DanielAttih/Computer-Temperature-Sensor/hardware/PCtemp.kicad_sch

## KiCad design hardware/PCtemp.kicad_sch (2026-10-24)

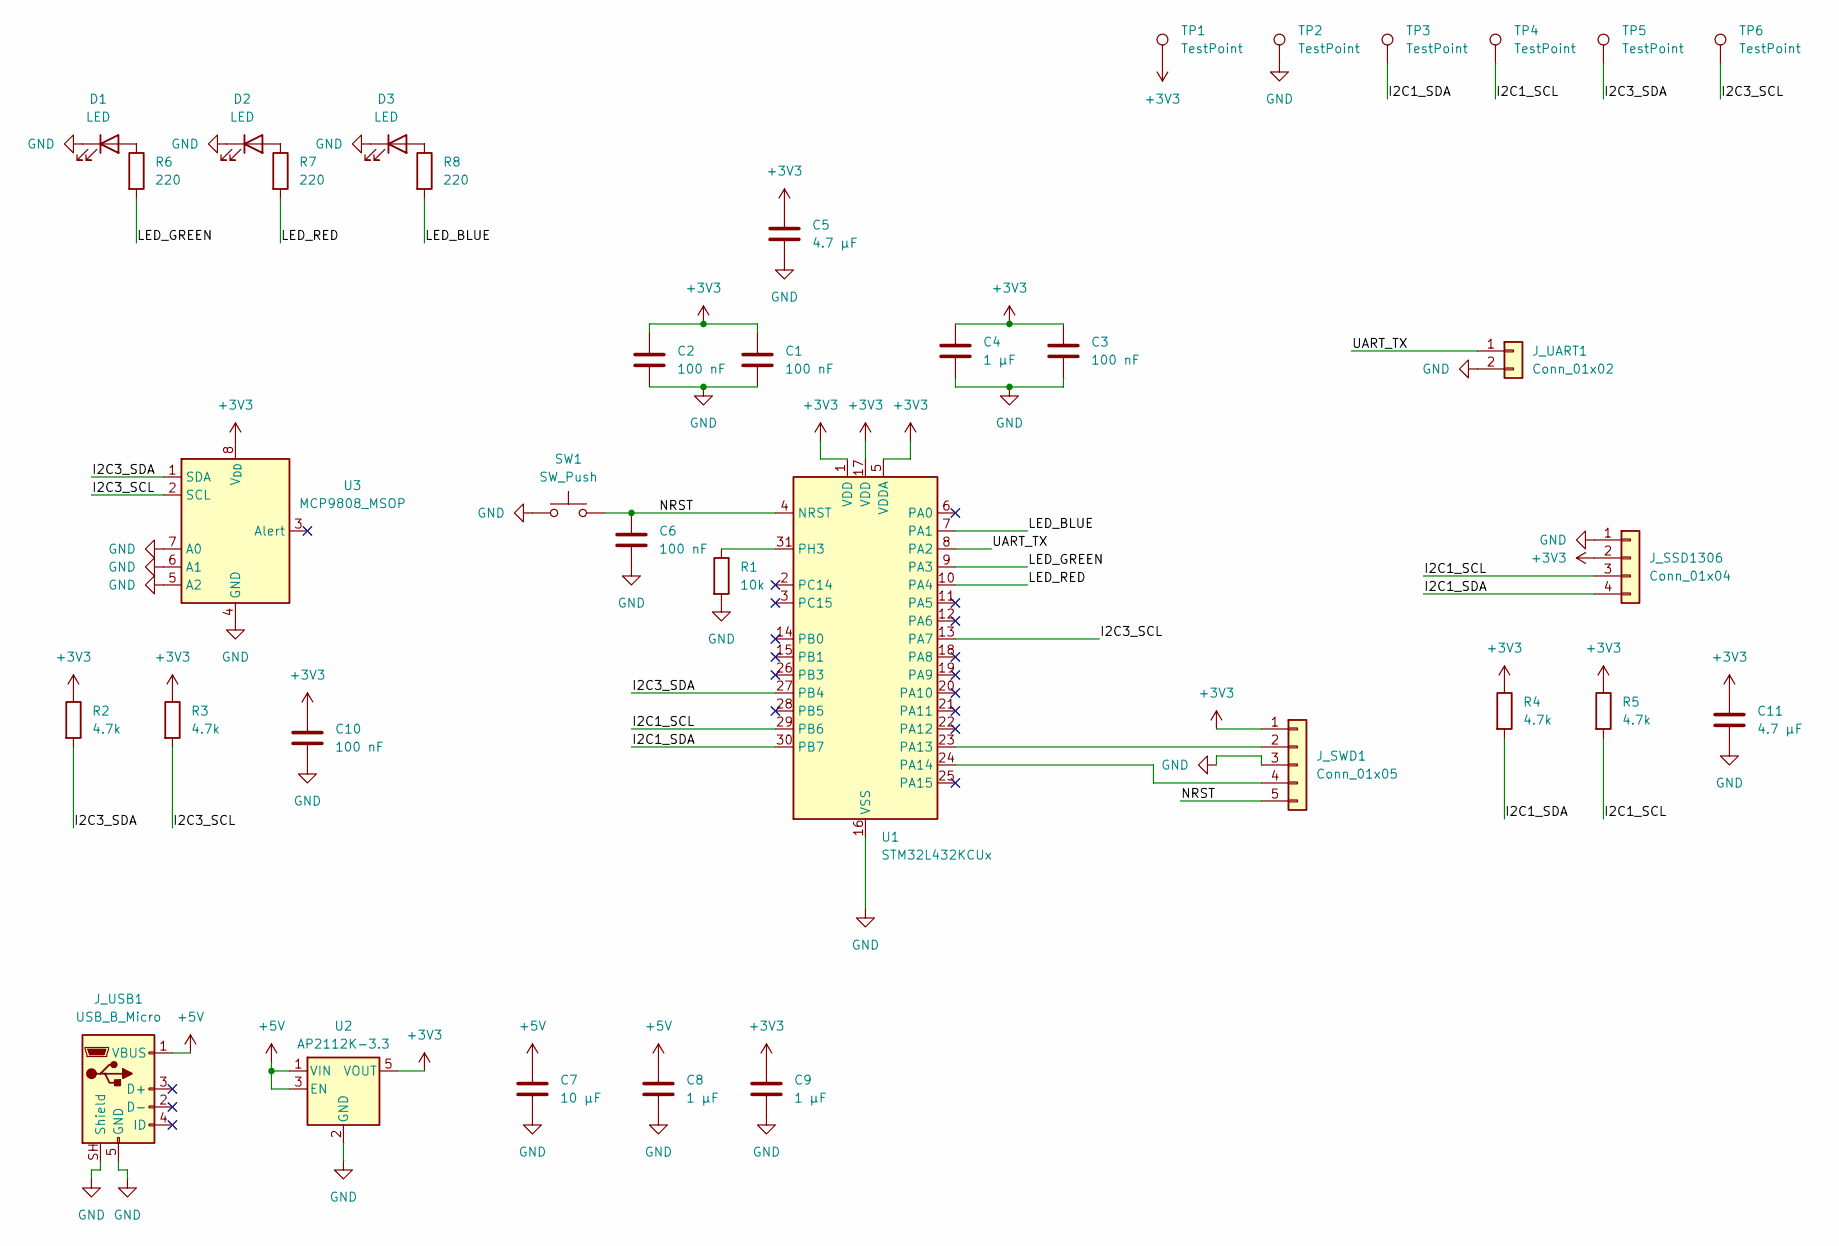
[picture p1: schematic PCtemp.kicad_sch]

Parts:
C1, C2, C3, C6, C10: 100 nF; C_0402_1005Metric
C4, C8, C9: 1 µF; C_0402_1005Metric
C5, C11: 4.7 µF; C_0603_1608Metric
C7: 10 µF; C_0603_1608Metric
D1, D2, D3: LED; LED_0805_2012Metric
J_SSD1306: Conn_01x04; PinHeader_1x04_P2.54mm_Vertical
J_SWD1: Conn_01x05; PinHeader_1x05_P2.54mm_Vertical
J_UART1: Conn_01x02; PinHeader_1x02_P2.54mm_Vertical
J_USB1: USB_B_Micro; USB_Micro-B_Amphenol_10118194_Horizontal
R1: 10k; R_0402_1005Metric
R2, R3, R4, R5: 4.7k; R_0402_1005Metric
R6, R7, R8: 220; R_0402_1005Metric
SW1: SW_Push; Panasonic_EVQPUJ_EVQPUA
TP1, TP2, TP3, TP4, TP5, TP6: TestPoint; TestPoint_Pad_D2.0mm
U1: STM32L432KCUx; QFN-32-1EP_5x5mm_P0.5mm_EP3.45x3.45mm
U2: AP2112K-3.3; SOT-23-5
U3: MCP9808_MSOP; MSOP-8_3x3mm_P0.65mm

Connections:
+3V3: C1.1, C2.1, C3.1, C4.1, C5.1, C9.1, C10.1, C11.1, J_SSD1306.2, J_SWD1.1, R2.1, R3.1, R4.1, R5.1, TP1.1, U1.1 (VDD), U1.5 (VDDA), U1.17 (VDD), U2.5 (VOUT), U3.8 (V_{DD})
+5V: C7.1, C8.1, J_USB1.1 (VBUS), U2.1 (VIN), U2.3 (EN)
GND: C1.2, C2.2, C3.2, C4.2, C5.2, C6.2, C7.2, C8.2, C9.2, C10.2, C11.2, D1.1 (K), D2.1 (K), D3.1 (K), J_SSD1306.1, J_SWD1.3, J_UART1.2, J_USB1.5 (GND), J_USB1.SH (Shield), R1.2, SW1.1, TP2.1, U1.16 (VSS), U1.32 (VSS), U1.33 (VSS), U2.2 (GND), U3.4 (GND), U3.5 (A2), U3.6 (A1), U3.7 (A0)
I2C1_SCL: J_SSD1306.3, R5.2, TP4.1, U1.29 (PB6)
I2C1_SDA: J_SSD1306.4, R4.2, TP3.1, U1.30 (PB7)
I2C3_SCL: R3.2, TP6.1, U1.13 (PA7), U3.2 (SCL)
I2C3_SDA: R2.2, TP5.1, U1.27 (PB4), U3.1 (SDA)
LED_BLUE: R8.2, U1.7 (PA1)
LED_GREEN: R6.2, U1.9 (PA3)
LED_RED: R7.2, U1.10 (PA4)
NRST: C6.1, J_SWD1.5, SW1.2, U1.4 (NRST)
unnamed: D1.2 (A), R6.1
unnamed: D2.2 (A), R7.1
unnamed: D3.2 (A), R8.1
unnamed: J_SWD1.2, U1.23 (PA13)
unnamed: J_SWD1.4, U1.24 (PA14)
unnamed: R1.1, U1.31 (PH3)
UART_TX: J_UART1.1, U1.8 (PA2)
