DanielAttih/Computer-Temperature-Sensor/firmware/Core/Src/main.c

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
/* Includes ------------------------------------------------------------------*/
#include "main.h"

/* USER CODE BEGIN Includes */
#include "ssd1306.h"
#include "fonts.h"
#include "MCP9808.h"
#include <stdlib.h>
#include <stdio.h>
#include <string.h>
#include <stdarg.h>
#include <stdbool.h>
/* USER CODE END Includes */

/* USER CODE BEGIN PD */
#define TEMP_HOT_F	90.0f 	/* red LED turns ON at or above this */
#define TEMP_OK_F	85.0f	/* red LED turns OFF only below this	 */

#define MAX_READ_FAILS	3	/* consecutive failed reads before declaring a fault */
/* USER CODE END PD */

I2C_HandleTypeDef hi2c1;
I2C_HandleTypeDef hi2c3;

UART_HandleTypeDef huart2;

/* USER CODE BEGIN PV */
void debug_print(const char *msg);
void myprintf(const char *fmt, ...);

//----------------------- Variables for OLED Display-------------------

char buf_C [16]; // Temperature in Celsius
char buf_F [16]; // Temperature in Fahrenheit

//----------------------- Variables for temperature logic and fault tolerance-----------------------
bool tooHot = false;	/* remembers the current state between loop passes */

uint8_t failCount   = 0;       /* consecutive failed reads so far */
bool sensorFault 	= false;   /* true while the fault is active   */
/* USER CODE END PV */

void SystemClock_Config(void);
static void MX_GPIO_Init(void);
static void MX_I2C1_Init(void);
static void MX_I2C3_Init(void);
static void MX_USART2_UART_Init(void);
/* USER CODE BEGIN 0 */
void debug_print(const char *msg)
{
  HAL_UART_Transmit(&huart2, (uint8_t *)msg, strlen(msg), 100);
}

void myprintf(const char *fmt, ...)
{
  static char buffer[256];
  va_list args;
  va_start(args, fmt);
  vsnprintf(buffer, sizeof(buffer), fmt, args);
  va_end(args);

  int len = strlen(buffer);
  HAL_UART_Transmit(&huart2, (uint8_t*)buffer, len, HAL_MAX_DELAY);

}
 // Helper functions that redraws the OLED's fixed text after error screen wipes it
static void oled_draw_static(void)
{
    SSD1306_Fill(SSD1306_COLOR_BLACK);
    SSD1306_GotoXY(0, 0);
    SSD1306_Puts("PC Case Temp", &Font_7x10, 1);
    SSD1306_GotoXY(0, 10);
    SSD1306_Puts("Temp: ", &Font_7x10, 1);
}
/* USER CODE END 0 */

/**
  * @brief  The application entry point.
  * @retval int
  */
int main(void)
{

  /* MCU Configuration--------------------------------------------------------*/

  /* Reset of all peripherals, Initializes the Flash interface and the Systick. */
  HAL_Init();

  /* Configure the system clock */
  SystemClock_Config();

  /* Initialize all configured peripherals */
  MX_GPIO_Init();
  MX_I2C1_Init();
  MX_I2C3_Init();
  MX_USART2_UART_Init();
  /* USER CODE BEGIN 2 */
  debug_print("\r\n ~ START ~\r\n\r"); // for PuTTY

  /*------------------------------------------------- Fault tolerance for startup----------------------------------------------------------------*/
  /* ---- MCP9808: retry forever. Attempts 1-3 are silent; from attempt 4 on,
   *      the red LED flashes between retries until the sensor answers. ---- */
  uint8_t attempts = 0;
  while (!MCP9808_Init(&hi2c3))
  {
	  /* Attempts is a uint8_t, so after 255 failed attempts it wraps to 0 and the red LED stops flashing for 3 passes.
	   * Cap it at 255, so it stays at 255, soo attempts >= 3 stay true and the LEED keeps flashing 					*/
	  if (attempts < 255) attempts++;
	  myprintf("MCP9808 FAIL(attempt %u)\r\n", attempts);
	  if (attempts >= 3)
	  {
		  HAL_GPIO_TogglePin(RED_LED_GPIO_Port, RED_LED_Pin);
	  }
	  HAL_Delay(250);
  }
  HAL_GPIO_WritePin(RED_LED_GPIO_Port, RED_LED_Pin, GPIO_PIN_RESET);  /* stop flashing */
  myprintf("MCP9808 OK\r\n");

  /* ---- SSD1306: 3 attempts, then continue without the display ---- */
  bool oledOK = false;
  for (uint8_t i = 0; i < 3 && !oledOK; i++) {
      oledOK = SSD1306_Init();            /* returns 1 on success, 0 on failure */
      if (!oledOK) {
          myprintf("SSD1306 FAIL (attempt %u)\r\n", i + 1);
          HAL_Delay(100);
      }
  }

  if (oledOK) {
      myprintf("SSD1306 OK\r\n");
      oled_draw_static();
  } else {
      myprintf("SSD1306 FAIL - continuing without display\r\n");
  }
/*---------------------------------------------------------------------------------------------------------------------------------------------*/
  /* USER CODE END 2 */

  /* Infinite loop */
  /* USER CODE BEGIN WHILE */
  while (1)
  {
	  /* Blue LED: solid = display OK, flashing = display failed.
	   * The loop runs every 500 ms, so toggling here gives a steady blink. */
	  if (oledOK) {
	     HAL_GPIO_WritePin(BLUE_LED_GPIO_Port, BLUE_LED_Pin, GPIO_PIN_SET);
	  } else {
	     HAL_GPIO_TogglePin(BLUE_LED_GPIO_Port, BLUE_LED_Pin);
	  }

	  float tempC;		// receives the temperature in Celsius
	  float tempF; 		// receives the temperature in Fahrenheit

	  if (MCP9808_ReadTempC(&hi2c3, &tempC, &tempF)) // &tempC = "address of tempC"
	  {												 // &tempF = "address of tempF"

		  failCount = 0;			/* a good read resets the streak */

		  if (sensorFault)			/* we just recovered from a fault */
		  {
			  sensorFault = false;
			  myprintf("Sensor recovered\r\n");
			  if (oledOK)
			  {
				  oled_draw_static();		/* redraw the title and label */
			  }

		  }

		  if(oledOK)
		  {
			  // Print in Celsius
			  SSD1306_GotoXY(42, 10);
			  snprintf(buf_C, sizeof(buf_C), "%.2f C", tempC);
			  SSD1306_Puts(buf_C, &Font_7x10, 1);

			  // Print in Fahrenheit
			  SSD1306_GotoXY(42, 20);
			  snprintf(buf_F, sizeof(buf_F), "%.2f F", tempF);
			  SSD1306_Puts(buf_F, &Font_7x10, 1);

		  }

		  // Debug print
		  myprintf("\nTemp: %.2f C\r\n", tempC);
		  myprintf("%.2f F\r\n", tempF);

		  /* Hysteresis: only change state when a threshold is crossed */
		  if (!tooHot && tempF >= TEMP_HOT_F)
		  {
			 tooHot = true;
		  } else if (tooHot && tempF < TEMP_OK_F)
		  {
			  tooHot = false;
		  }

		  HAL_GPIO_WritePin(RED_LED_GPIO_Port,   RED_LED_Pin,   tooHot ? GPIO_PIN_SET   : GPIO_PIN_RESET);
		  HAL_GPIO_WritePin(GREEN_LED_GPIO_Port, GREEN_LED_Pin, tooHot ? GPIO_PIN_RESET : GPIO_PIN_SET);

	  } else {
	      myprintf("Temp read failed (%u)\r\n", failCount + 1);

	      /* Reset the I2C3 peripheral so it can recover after a bus glitch */
	      HAL_I2C_DeInit(&hi2c3);
	      MX_I2C3_Init();

	      if (failCount < MAX_READ_FAILS)
	      {
	    	  failCount++;
	      }

	      if (failCount >= MAX_READ_FAILS)
	      {
	    	  if (!sensorFault)				/* first pass of the fault only */
	    	  {
	    		  sensorFault =  true;
	    		  tooHot = false;			/* forget the old hot/ok state */
	    		  HAL_GPIO_WritePin(GREEN_LED_GPIO_Port, GREEN_LED_Pin, GPIO_PIN_RESET);

	    		  if(oledOK)
	    		  {
	    			  SSD1306_Fill(SSD1306_COLOR_BLACK);
	    			  SSD1306_GotoXY(0, 0);
	    			  SSD1306_Puts("PC Case Temp", &Font_7x10, 1);
	    			  SSD1306_GotoXY(0, 20);
	    			  SSD1306_Puts("SENSOR ERR", &Font_7x10, 1);
	    		  }
	    	  }

	    	  HAL_GPIO_TogglePin(RED_LED_GPIO_Port, RED_LED_Pin);   /* flash red */
	      }
	  }

	  if(oledOK)
	  {
		  SSD1306_UpdateScreen();
	  }

	  HAL_Delay(500);

    /* USER CODE END WHILE */

    /* USER CODE BEGIN 3 */
  }
  /* USER CODE END 3 */
}

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
