DanielAttih/Computer-Temperature-Sensor/firmware/Core/Inc/main.h

#define BLUE_LED_Pin GPIO_PIN_1
#define BLUE_LED_GPIO_Port GPIOA
#define RED_LED_Pin GPIO_PIN_3
#define RED_LED_GPIO_Port GPIOA
#define GREEN_LED_Pin GPIO_PIN_4
#define GREEN_LED_GPIO_Port GPIOA
#define MCP9808_SCL_Pin GPIO_PIN_7
#define MCP9808_SCL_GPIO_Port GPIOA
#define SWDIO_Pin GPIO_PIN_13
#define SWDIO_GPIO_Port GPIOA
#define SWCLK_Pin GPIO_PIN_14
#define SWCLK_GPIO_Port GPIOA
#define MCP9808_SDA_Pin GPIO_PIN_4
#define MCP9808_SDA_GPIO_Port GPIOB
#define SSD1306_SCL_Pin GPIO_PIN_6
#define SSD1306_SCL_GPIO_Port GPIOB
#define SSD1306_SDA_Pin GPIO_PIN_7
#define SSD1306_SDA_GPIO_Port GPIOB
