DanielAttih/Computer-Temperature-Sensor/(commit log)

2026-04-21 Enhance README with project details and parts list
    Added detailed steps and parts information for the sensor project.
2026-04-28 Revise STM32L432KC links and board description
    Updated links and descriptions for the STM32L432KC microcontroller and development board.
2026-05-10 Revise power budget current values in README
    Updated power budget section with component current values.
2026-09-24 Update design choice details in README
    Clarified the design choice regarding the use of a bare IC and specified the development board.
2026-10-23 Update README with MCP9808 Breakout Board details
    Added information about the MCP9808 Breakout Board used for prototyping.
2026-10-23 Document Debug UART header and its connection
    Added details about the Debug UART header and its usage for viewing debug messages.
2026-10-23 Add firmware notes for PC Case Temp Monitor v2
    Added detailed firmware notes for PC Case Temp Monitor, including functionality, pin mapping, file roles, driver details, fault handling, lessons learned, and test checklist.
2026-10-23 Update firmware notes with debug UART and flashing info
    Added notes on debug UART header and flashing/debugging methods.
2026-10-24 Add firmware, KiCad schematic, and organize docs
